teapotlaboratories/atlas/hardware/kicad/atlas.kicad_pcb

## KiCad design hardware/kicad/atlas.kicad_pcb (2024-10-26)

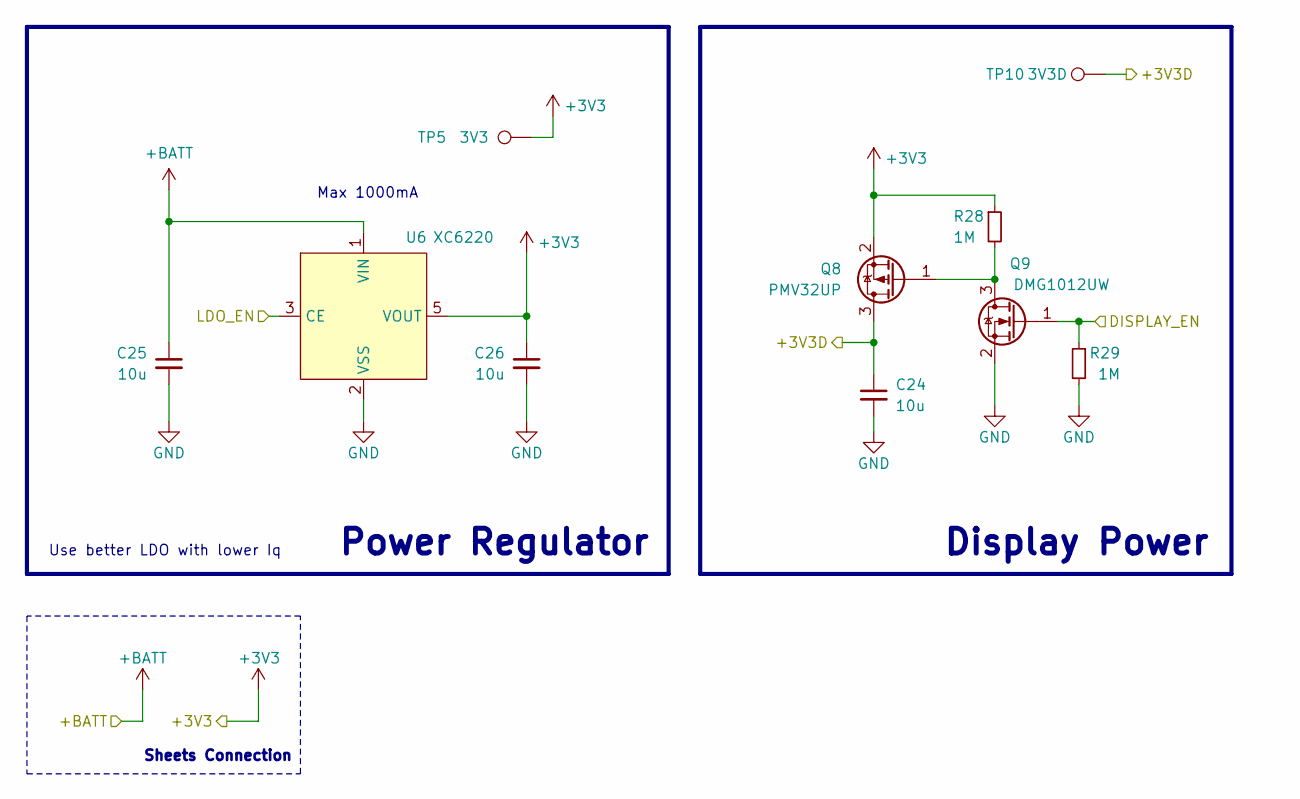
[picture p1: schematic power_regulator.kicad_sch, Teapotlabs Atlas]

Parts:
C24, C25, C26: 10u; C_0603_1608Metric; Part Description Ceramic Capacitor 10V 10uF X5R ±10% 0603
Q8: PMV32UP; SOT-23; Part Description MOSFET P Channel 20V 4A 52mΩ@4.5V
Q9: DMG1012UW; SOT-323_SC-70; Part Description MOSFET N Channel 20V 1A 450mΩ@4.5V 600m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
R28, R29: 1M; R_0402_1005Metric; Part Description Resistor 62.5mW ±1% 1MΩ
TP5: 3V3; TestPoint_Pad_D1.0mm
TP10: 3V3D; TestPoint_Pad_D1.0mm
U6: XC6220; SOT-23-5; Part Description LDO Voltage Regulators 1A

Connections:
/+3V3D: C24.1, Q8.3 (D), TP10.1; also elsewhere on the board
/Main Controller/DISPLAY_EN: Q9.1 (G), R29.1; also elsewhere on the board
/Power Regulator/LDO_EN: U6.3 (CE); also elsewhere on the board
unnamed: Q8.1 (G), Q9.3 (D), R28.2

Notes on the sheet:
Use better LDO with lower Iq
Max 1000mA
Display Power
Sheets Connection
Power Regulator

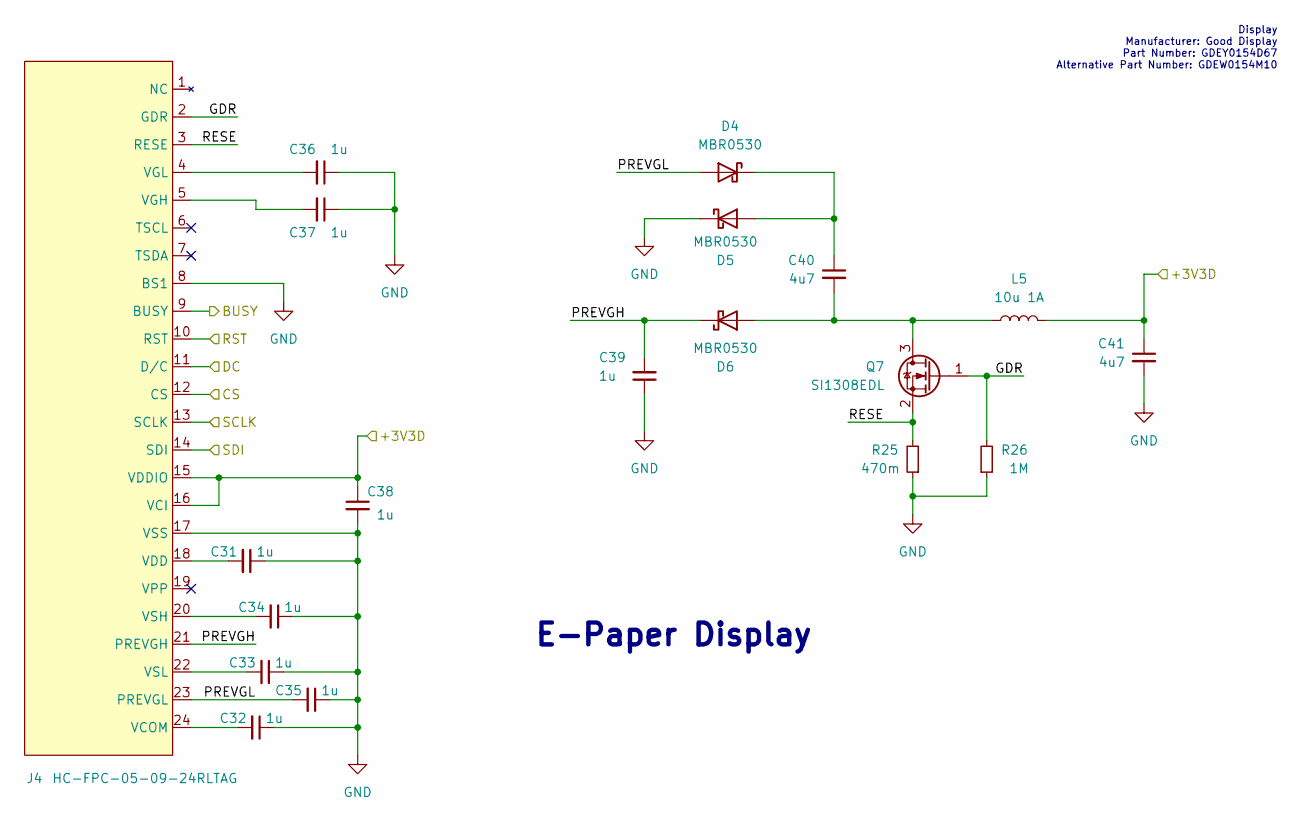
[picture p2: schematic display.kicad_sch, Teapotlabs Atlas]

Parts:
C31, C32, C33, C34, C35, C36, C37, C38, C39: 1u; C_0402_1005Metric; Part Description Ceramic Capacitors 50V 1uF X5R ±10%
C40, C41: 4u7; C_0603_1608Metric; Part Description Ceramic Capacitors 25V 4.7uF X5R ±10%
D4, D5, D6: MBR0530; D_SOD-123; Part Description Schottky Barrier Diodes 30V 430mV@500mA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
J4: HC-FPC-05-09-24RLTAG; FPC-SMD_24P-P0.50_HC-FPC-05-09-24RLTAG; Part Description FFC & FPC Connectors Clamshell 24P Bott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
L5: 10u 1A; L_Changjiang_FNR4012S; Part Description Power Inductors 1A 10uH ±20% 1.1A SMD,4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
Q7: SI1308EDL; SOT-323_SC-70; Part Description MOSFET N Channel 30V 1.4A 132mΩ@10V,1.4A
R25: 470m; R_0402_1005Metric; Part Description Resistor 125mW ±1% 470mΩ
R26: 1M; R_0402_1005Metric; Part Description Resistors 100mW ±1% 1MΩ

Connections:
/+3V3D: C38.1, C41.1, J4.15 (VDDIO), J4.16 (VCI), L5.1; also elsewhere on the board
/Display/BUSY: J4.9 (BUSY); also elsewhere on the board
/Display/CS: J4.12 (CS); also elsewhere on the board
/Display/DC: J4.11 (D/C); also elsewhere on the board
/Display/GDR: J4.2 (GDR), Q7.1 (G), R26.2
/Display/PREVGH: C39.2, D6.1 (K), J4.21 (PREVGH)
/Display/PREVGL: C35.2, D4.2 (A), J4.23 (PREVGL)
/Display/RESE: J4.3 (RESE), Q7.2 (S), R25.2
/Display/RST: J4.10 (RST); also elsewhere on the board
/Display/SCLK: J4.13 (SCLK); also elsewhere on the board
/Display/SDI: J4.14 (SDI); also elsewhere on the board
unnamed: C40.1, D4.1 (K), D5.2 (A)
unnamed: C40.2, D6.2 (A), L5.2, Q7.3 (D)
unnamed: C32.2, J4.24 (VCOM)
unnamed: C31.2, J4.18 (VDD)
unnamed: C37.2, J4.5 (VGH)
unnamed: C36.2, J4.4 (VGL)
unnamed: C34.2, J4.20 (VSH)
unnamed: C33.2, J4.22 (VSL)

Notes on the sheet:
Display Manufacturer: Good Display Part Number: GDEY0154D67 Alternative Part Number: GDEW0154M10
E-Paper Display

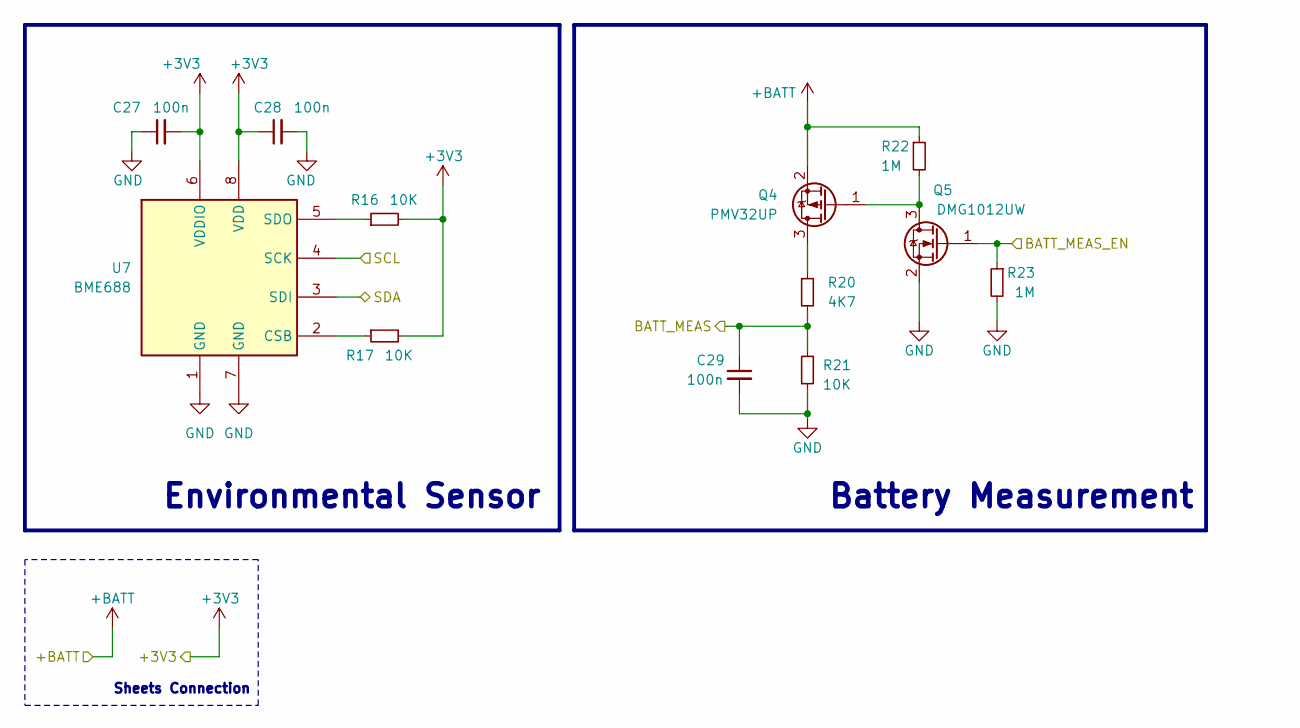
[picture p3: schematic sensor.kicad_sch, Teapotlabs Atlas]

Parts:
C27, C28, C29: 100n; C_0402_1005Metric; Part Description Ceramic Capacitor 16V 100nF X7R ±10%
Q4: PMV32UP; SOT-23; Part Description MOSFET P Channel 20V 4A 52mΩ@4.5V
Q5: DMG1012UW; SOT-323_SC-70; Part Description MOSFET N Channel 20V 1A 450mΩ@4.5V 600m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
R16, R17, R21: 10K; R_0402_1005Metric; Part Description Resistors 62.5mW ±1% 10kΩ
R20: 4K7; R_0402_1005Metric; Part Description Resistor 62.5mW ±1% 4.7kΩ
R22, R23: 1M; R_0402_1005Metric; Part Description Resistor 62.5mW ±1% 1MΩ
U7: BME688; BME680-PSON80P300X300X100-8N; Part Description Gas, Humidity, Pressure, Temperature Se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

Connections:
/Main Controller/BATT_MEAS: C29.1, R20.2, R21.2; also elsewhere on the board
/Main Controller/BATT_MEAS_EN: Q5.1 (G), R23.1; also elsewhere on the board
/SCL: U7.4 (SCK); also elsewhere on the board
/SDA: U7.3 (SDI); also elsewhere on the board
unnamed: Q4.3 (D), R20.1
unnamed: Q4.1 (G), Q5.3 (D), R22.2
unnamed: R17.1, U7.2 (CSB)
unnamed: R16.1, U7.5 (SDO)

Notes on the sheet:
Sheets Connection
Battery Measurement
Environmental Sensor

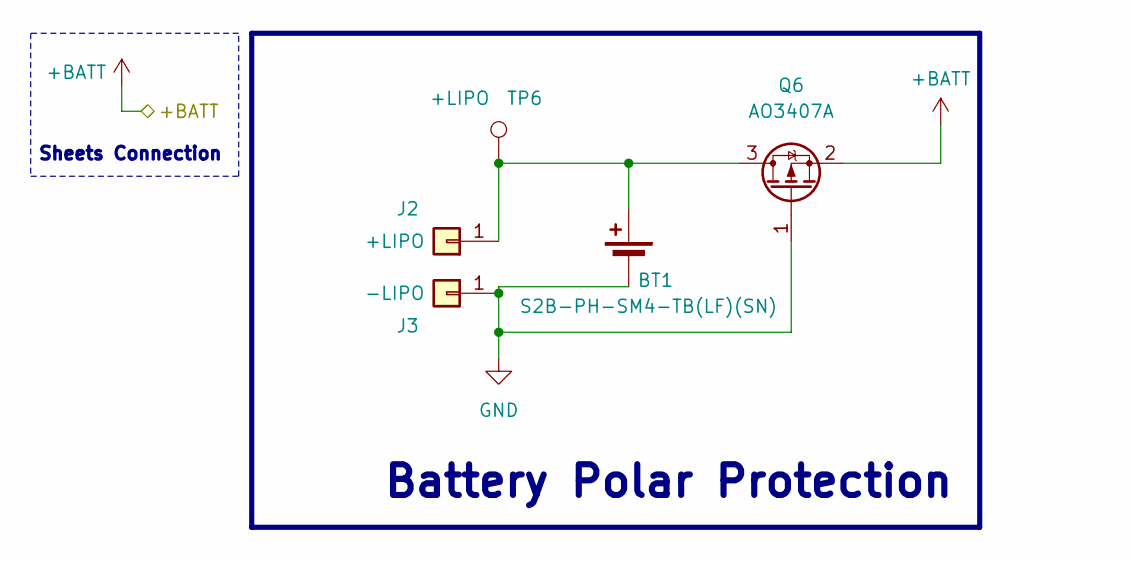
[picture p4: schematic battery.kicad_sch, Teapotlabs Atlas]

Parts:
BT1: S2B-PH-SM4-TB(LF)(SN); JST_PH_S2B-PH-SM4-TB_1x02-1MP_P2.00mm_Horizontal; Part Description Wire To Board Connector 1x2P PH 2mm Mal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
J2: +LIPO; TestPoint_THTPad_D1.0mm_Drill0.5mm; Part Description On-board Pad
J3: -LIPO; TestPoint_THTPad_D1.0mm_Drill0.5mm; Part Description On-board Pad
Q6: AO3407A; SOT-23; Part Description MOSFET P Channel 30V 4.3A 48mΩ@10V,4.3A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
TP6: +LIPO; TestPoint_Pad_D1.0mm

Connections:
unnamed: BT1.1 (+), J2.1, Q6.3 (D), TP6.1

Notes on the sheet:
Battery Polar Protection
Sheets Connection

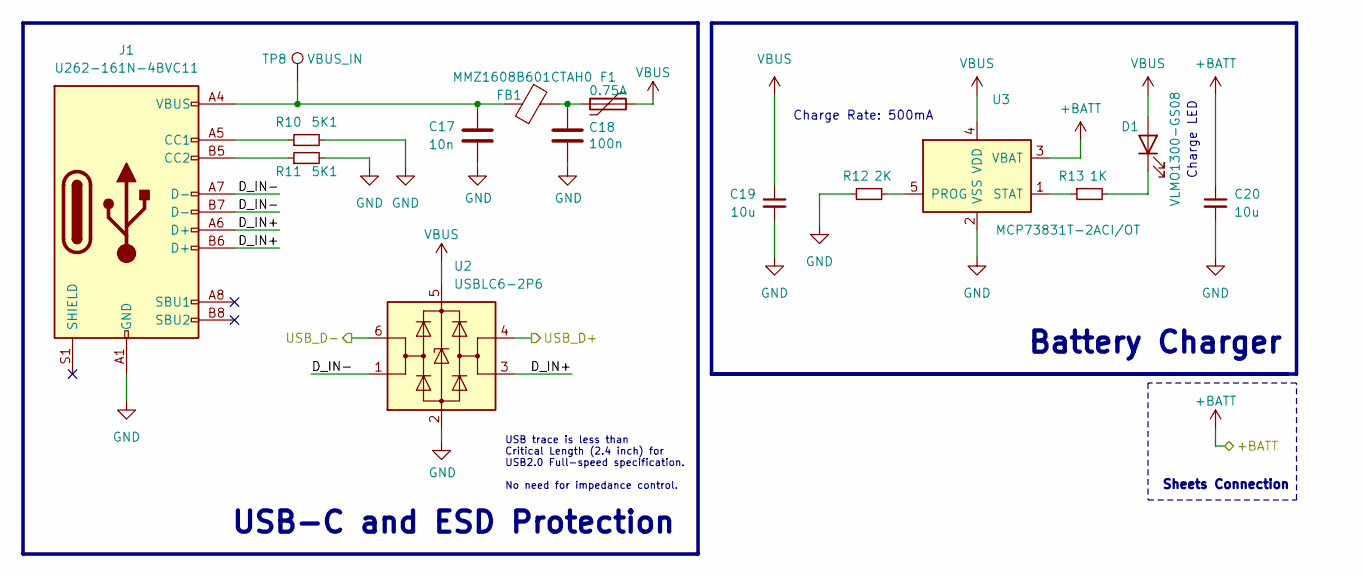
[picture p5: schematic usb_power.kicad_sch, Teapotlabs Atlas]

Parts:
C17: 10n; C_0402_1005Metric; Part Description Ceramic Capacitors 16V 10nF X7R ±10%
C18: 100n; C_0402_1005Metric; Part Description Ceramic Capacitor 16V 100nF X7R ±10%
C19, C20: 10u; C_0603_1608Metric; Part Description Ceramic Capacitor 10V 10uF X5R ±10% 0603
D1: VLMO1300-GS08; LED_0603_1608Metric; Part Description Orange 2V 20mA
F1: 0.75A; Fuse_0805_2012Metric; Part Description Resettable Fuses 6V 750mA 40A 1.5A
FB1: MMZ1608B601CTAH0; L_0603_1608Metric; Part Description Ferrite Beads 400mΩ ±25% 600Ω@100MHz
J1: U262-161N-4BVC11; USB_C_Receptacle_XKB_U262-16XN-4BVC11; Part Description USB Connectors Type-C 3A USB 3.1 16P
R10, R11: 5K1; R_0402_1005Metric; Part Description Resistor 62.5mW ±1% 5.1kΩ
R12: 2K; R_0402_1005Metric; Part Description Resistor 62.5mW ±1% 2kΩ
R13: 1K; R_0402_1005Metric; Part Description Resistor 62.5mW ±1% 1kΩ
TP8: VBUS_IN; TestPoint_Pad_D1.0mm
U2: USBLC6-2P6; SOT-666; Part Description ESD Protection 6V 17V 2 Unidirectional 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
U3: MCP73831T-2ACI/OT; SOT-23-5; Part Description Battery Management IC 6V LiPoly 1500mA

Connections:
/Main Controller/USB_D+: U2.4 (I/O2); also elsewhere on the board
/Main Controller/USB_D-: U2.6 (I/O1); also elsewhere on the board
/USB Power/D_IN+: J1.A6 (D+), J1.B6 (D+), U2.3 (I/O2)
/USB Power/D_IN-: J1.A7 (D-), J1.B7 (D-), U2.1 (I/O1)
unnamed: C17.1, FB1.1, J1.A4 (VBUS), J1.A9 (VBUS), J1.B4 (VBUS), J1.B9 (VBUS), TP8.1
unnamed: C18.1, F1.1, FB1.2
unnamed: D1.1 (K), R13.2
unnamed: J1.A5 (CC1), R10.1
unnamed: J1.B5 (CC2), R11.1
unnamed: R12.1, U3.5 (PROG)
unnamed: R13.1, U3.1 (STAT)
VBUS: C19.1, D1.2 (A), F1.2, U2.5 (VBUS), U3.4 (VDD)

Notes on the sheet:
Sheets Connection
Charge Rate: 500mA
Battery Charger
USB-C and ESD Protection
Charge LED
USB trace is less than Critical Length (2.4 inch) for USB2.0 Full-speed specification. No need for impedance control.

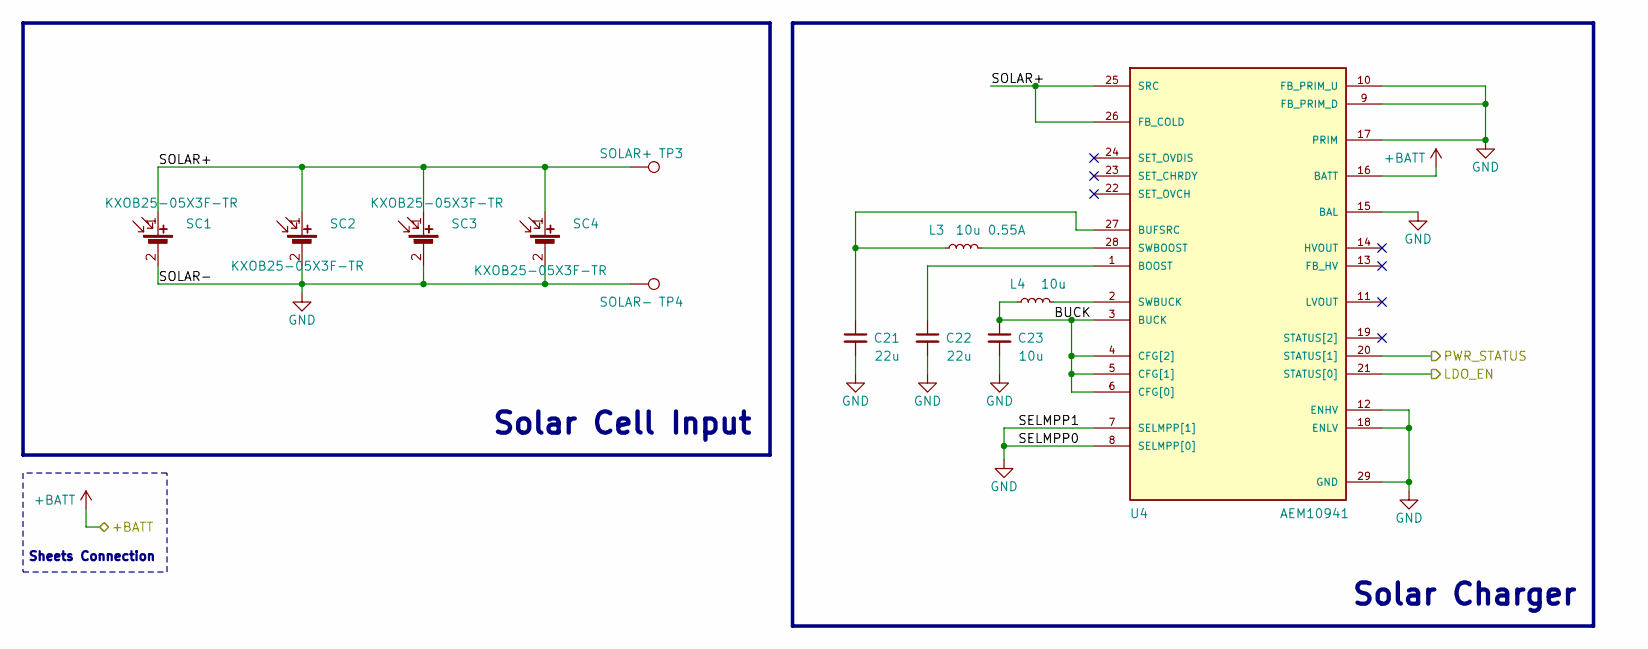
[picture p6: schematic solar_power.kicad_sch, Teapotlabs Atlas]

Parts:
C21, C22: 22u; C_0603_1608Metric; Part Description Ceramic Capacitors 10V 22uF X5R ±20%
C23: 10u; C_0603_1608Metric; Part Description Ceramic Capacitor 10V 10uF X5R ±10%
L3: 10u 0.55A; IND_LPS4012-103MRB; Part Description Power Inductors - SMD 10uH Shld 20% 1.1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
L4: 10u; L_0603_1608Metric; Part Description Power Inductors 10uH ±20% 90mA 1.05Ω
SC1, SC2, SC3, SC4: KXOB25-05X3F-TR; KXOB25-05X3F; Part Description Solar Cell G3 Thin 2.07V 30.7MW
TP3: SOLAR+; TestPoint_Pad_D1.0mm
TP4: SOLAR-; TestPoint_Pad_D1.0mm
U4: AEM10941; QFN-28-1EP_5x5mm_P0.5mm_EP3.35x3.35mm; Part Description PMIC IC - Photovoltaic Energy Harvestin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

Connections:
/Main Controller/PWR_STATUS: U4.20 (STATUS[1]); also elsewhere on the board
/Power Regulator/LDO_EN: U4.21 (STATUS[0]); also elsewhere on the board
/Solar Power/BUCK: C23.1, L4.1, U4.3 (BUCK), U4.4 (CFG[2]), U4.5 (CFG[1]), U4.6 (CFG[0])
/Solar Power/SOLAR+: SC1.1 (+), SC2.1 (+), SC3.1 (+), SC4.1 (+), TP3.1, U4.25 (SRC), U4.26 (FB_COLD)
unnamed: C22.1, U4.1 (BOOST)
unnamed: C21.1, L3.1, U4.27 (BUFSRC)
unnamed: L3.2, U4.28 (SWBOOST)
unnamed: L4.2, U4.2 (SWBUCK)

Notes on the sheet:
Solar Cell Input
Sheets Connection
Solar Charger

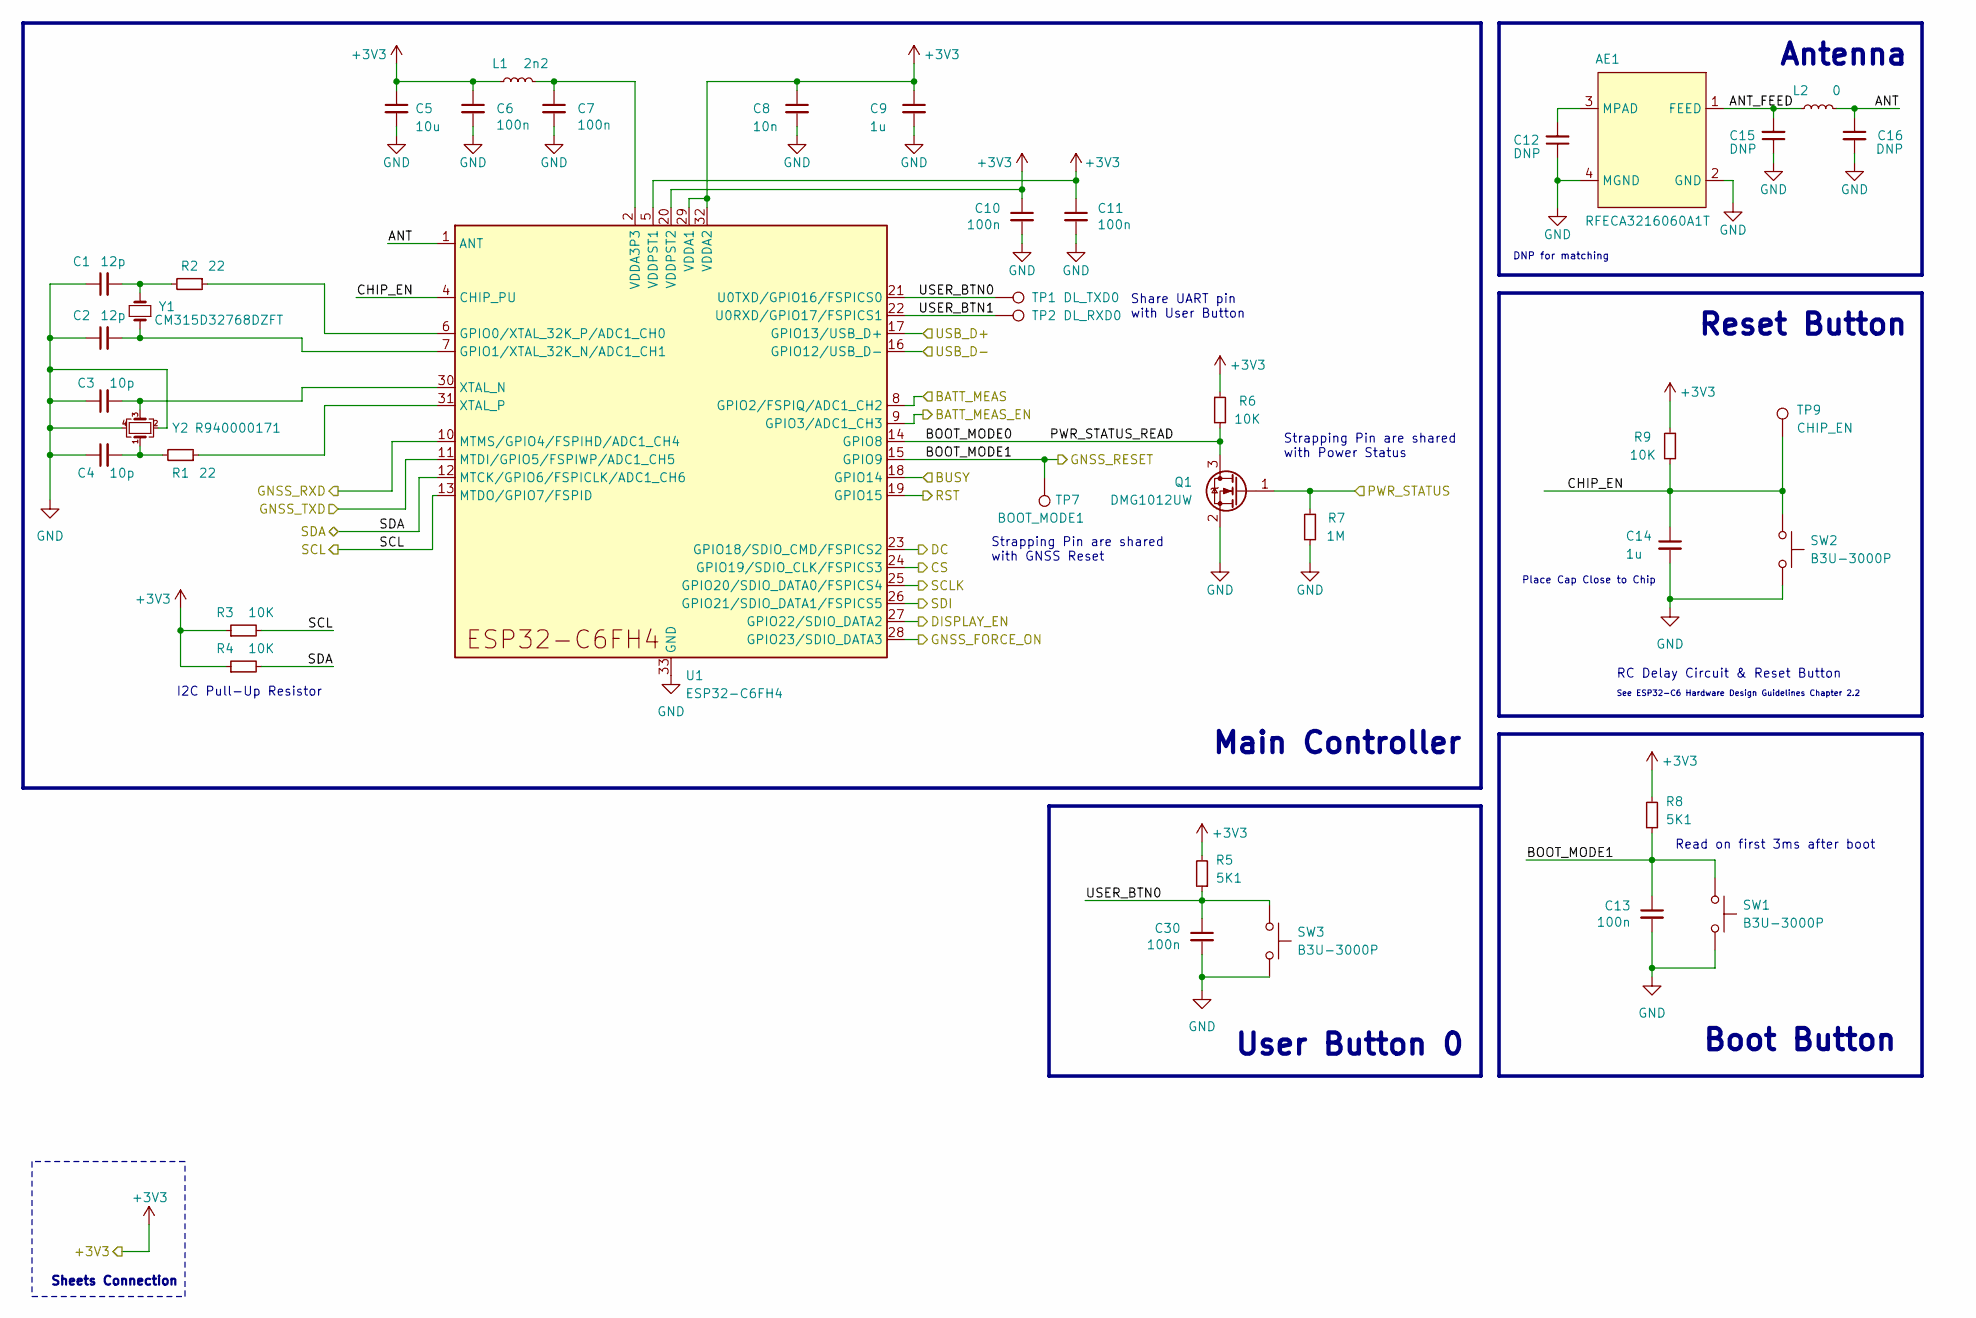
[picture p7: schematic main_controller.kicad_sch, Teapotlabs Atlas]

Parts:
AE1: RFECA3216060A1T; Part Description Chip RF Antenna 2.4GHz 2dBi
C1, C2: 12p; C_0402_1005Metric; Part Description Ceramic Capacitors 50V 12pF C0G ±1%
C3, C4: 10p; C_0402_1005Metric; Part Description Ceramic Capacitors 50V 10pF C0G ±1%
C5: 10u; C_0603_1608Metric; Part Description Ceramic Capacitor 10V 10uF X5R ±10% 0603
C6, C7, C10, C11, C13, C30: 100n; C_0402_1005Metric; Part Description Ceramic Capacitor 16V 100nF X7R ±10%
C8: 10n; C_0402_1005Metric; Part Description Ceramic Capacitors 16V 10nF X7R ±10%
C9, C14: 1u; C_0402_1005Metric; Part Description Ceramic Capacitors 10V 1uF X7R ±10%
C12, C15, C16: DNP; C_0402_1005Metric
L1: 2n2; L_0402_1005Metric; Part Description Power Inductors 2.53A 2.2nH ±2%
L2: 0; L_0402_1005Metric; Part Description Resistor 62.5mW ±1% 0Ω
Q1: DMG1012UW; SOT-323_SC-70; Part Description MOSFET N Channel 20V 1A 450mΩ@4.5V,600m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
R1, R2: 22; R_0402_1005Metric; Part Description Resistor 62.5mW ±1% 22Ω
R3, R4, R6, R9: 10K; R_0402_1005Metric; Part Description Resistors 62.5mW ±1% 10kΩ
R5, R8: 5K1; R_0402_1005Metric; Part Description Resistor 62.5mW ±1% 5.1kΩ
R7: 1M; R_0402_1005Metric; Part Description Resistor 62.5mW ±1% 1MΩ
SW1, SW2, SW3: B3U-3000P; SW_SPST_B3U-3000P; Part Description Tactile Switches NO 50mA 100MΩ 12V 1.59N
TP1: DL_TXD0; TestPoint_Pad_D1.0mm
TP2: DL_RXD0; TestPoint_Pad_D1.0mm
TP7: BOOT_MODE1; TestPoint_Pad_D1.0mm
TP9: CHIP_EN; TestPoint_Pad_D1.0mm
U1: ESP32-C6FH4; QFN-32-1EP_5x5mm_P0.5mm_EP3.6x3.6mm; Part Description Wireless SOC Bluetooth, WiFi Bluetooth 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
Y1: CM315D32768DZFT; Crystal_SMD_3215-2Pin_3.2x1.5mm; Part Description Crystals 32.768kHz 12.5pF ±20ppm
Y2: R940000171; Crystal_SMD_2016-4Pin_2.0x1.6mm; Part Description Crystals 40MHz 9pF ±10ppm

Connections:
/Display/BUSY: U1.18 (GPIO14); also elsewhere on the board
/Display/CS: U1.24 (GPIO19/SDIO_CLK/FSPICS3); also elsewhere on the board
/Display/DC: U1.23 (GPIO18/SDIO_CMD/FSPICS2); also elsewhere on the board
/Display/RST: U1.19 (GPIO15); also elsewhere on the board
/Display/SCLK: U1.25 (GPIO20/SDIO_DATA0/FSPICS4); also elsewhere on the board
/Display/SDI: U1.26 (GPIO21/SDIO_DATA1/FSPICS5); also elsewhere on the board
/GNSS/GNSS_RXD: U1.10 (MTMS/GPIO4/FSPIHD/ADC1_CH4); also elsewhere on the board
/GNSS/GNSS_TXD: U1.11 (MTDI/GPIO5/FSPIWP/ADC1_CH5); also elsewhere on the board
/Main Controller/ANT: C16.1, L2.2, U1.1 (ANT)
/Main Controller/ANT_FEED: AE1.1 (FEED), C15.2, L2.1
/Main Controller/BATT_MEAS: U1.8 (GPIO2/FSPIQ/ADC1_CH2); also elsewhere on the board
/Main Controller/BATT_MEAS_EN: U1.9 (GPIO3/ADC1_CH3); also elsewhere on the board
/Main Controller/BOOT_MODE0: Q1.3 (D), R6.2, U1.14 (GPIO8)
/Main Controller/BOOT_MODE1: C13.1, R8.1, SW1.1, TP7.1, U1.15 (GPIO9); also elsewhere on the board
/Main Controller/CHIP_EN: C14.1, R9.2, SW2.1, TP9.1, U1.4 (CHIP_PU)
/Main Controller/DISPLAY_EN: U1.27 (GPIO22/SDIO_DATA2); also elsewhere on the board
/Main Controller/PWR_STATUS: Q1.1 (G), R7.1; also elsewhere on the board
/Main Controller/USB_D+: U1.17 (GPIO13/USB_D+); also elsewhere on the board
/Main Controller/USB_D-: U1.16 (GPIO12/USB_D-); also elsewhere on the board
/Main Controller/USER_BTN0: C30.1, R5.1, SW3.1, TP1.1, U1.21 (U0TXD/GPIO16/FSPICS0)
/Main Controller/USER_BTN1: TP2.1, U1.22 (U0RXD/GPIO17/FSPICS1)
/SCL: R3.2, U1.13 (MTDO/GPIO7/FSPID); also elsewhere on the board
/SDA: R4.2, U1.12 (MTCK/GPIO6/FSPICLK/ADC1_CH6); also elsewhere on the board
unnamed: AE1.3 (MPAD), C12.2
unnamed: C7.1, L1.2, U1.2 (VDDA3P3), U1.3 (VDDA3P3)
unnamed: R2.1, U1.6 (GPIO0/XTAL_32K_P/ADC1_CH0)

Notes on the sheet:
Place Cap Close to Chip
Reset Button
Antenna
DNP for matching
Main Controller
Sheets Connection
User Button 0
Share UART pin with User Button
Boot Button
See ESP32-C6 Hardware Design Guidelines Chapter 2.2
RC Delay Circuit & Reset Button
Read on first 3ms after boot
I2C Pull-Up Resistor
Strapping Pin are shared with Power Status
Strapping Pin are shared with GNSS Reset

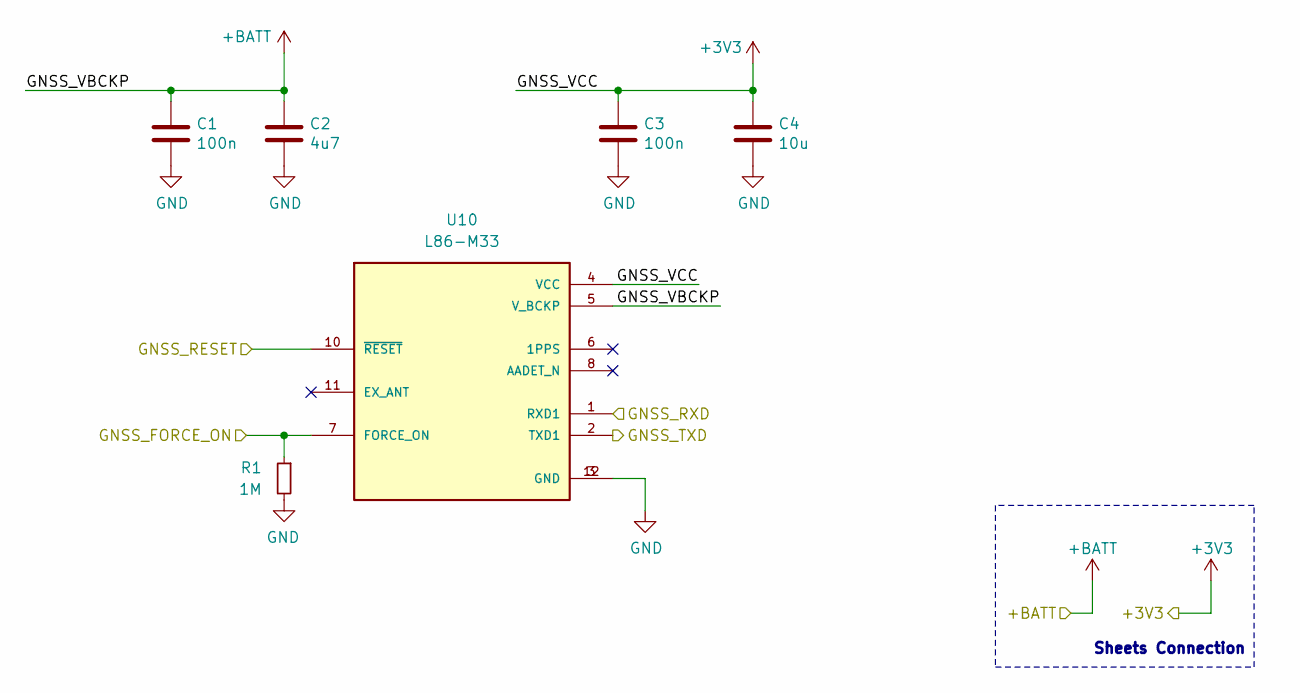
[picture p8: schematic gnss.kicad_sch, Teapotlabs Atlas]

Parts:
C1, C3: 100n; C_0603_1608Metric
C2: 4u7; C_0603_1608Metric
C4: 10u; C_0603_1608Metric
R1: 1M; R_0402_1005Metric
U10: L86-M33

Connections:
/GNSS/GNSS_RXD: U10.1 (RXD1); also elsewhere on the board
/GNSS/GNSS_TXD: U10.2 (TXD1); also elsewhere on the board
/Main Controller/BOOT_MODE1: U10.10 (~RESET); also elsewhere on the board

Notes on the sheet:
Sheets Connection

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
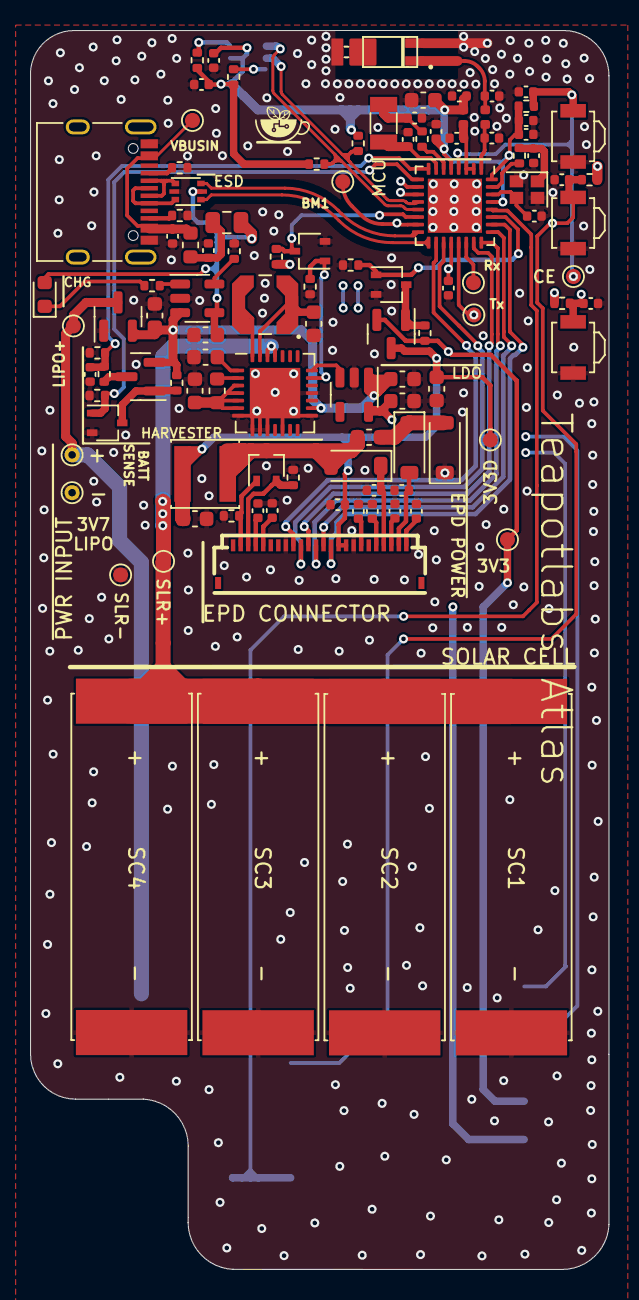
[picture p9: board atlas.kicad_pcb from above]

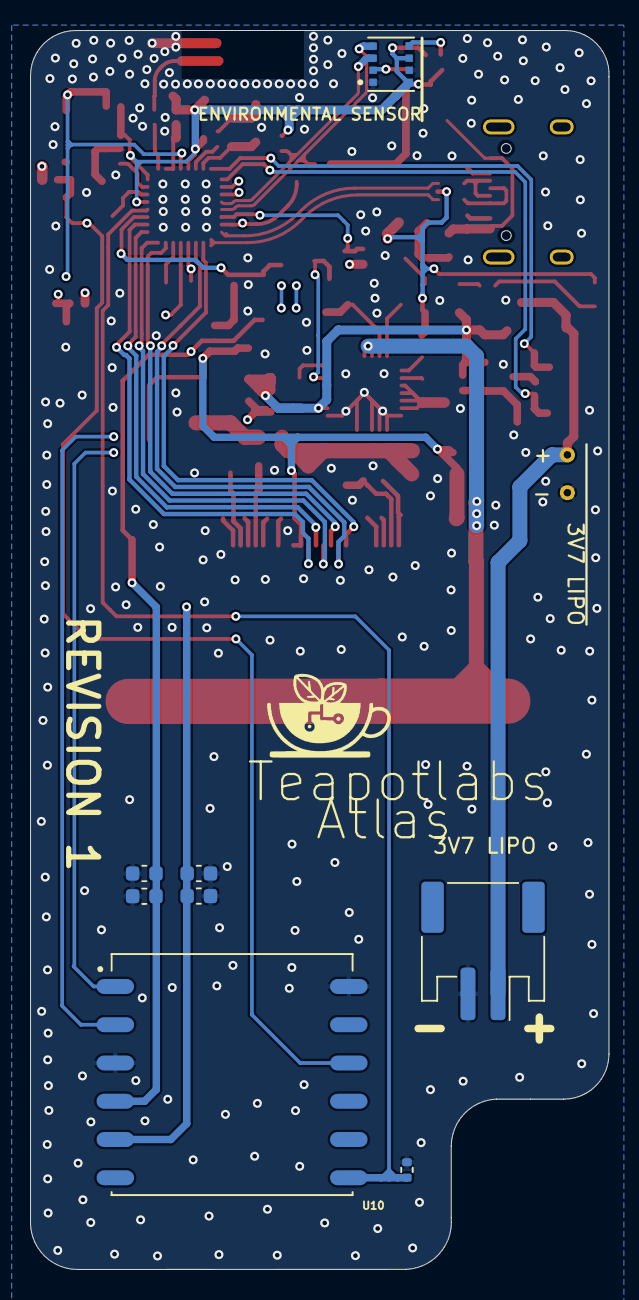
[picture p10: board atlas.kicad_pcb from below]

Board: 4 copper layers, 38.4 x 82.2 mm, 119 parts (8 on the bottom side), 71 nets.

Other parts of the board:
C42, C44: 100n; C_0603_1608Metric
C43: 4u7; C_0603_1608Metric
C45: 10u; C_0603_1608Metric
R15: 1M; R_0402_1005Metric
