teapotlaboratories/atlas/(commit log)

2024-10-19 initial upload
    [atlas.kicad_pcb, atlas.kicad_sch, battery.kicad_sch, display.kicad_sch, gnss.kicad_sch, main_controller.kicad_sch, power_regulator.kicad_sch, sensor.kicad_sch]
2024-10-20 update schematics with gnss
    [atlas.kicad_sch, gnss.kicad_sch, main_controller.kicad_sch, solar_power.kicad_sch]
2024-10-20 update pcb
    [atlas.kicad_pcb, gnss.kicad_sch, main_controller.kicad_sch]
2024-10-20 update design
    [atlas.kicad_pcb]
2024-10-21 Added a button for menu control (only pcb and no routing)
    [atlas.kicad_pcb]
2024-10-22 add second user button
    [atlas.kicad_pcb, main_controller.kicad_sch]
2024-10-22 added led symbols and placements on pcb.
    [atlas.kicad_pcb]
2024-10-25 Revert "added led symbols and placements on pcb."
    This reverts commit 775bc6ae91366f689438663b29cde4e2220ca0a7.
    [atlas.kicad_pcb]
2024-10-26 add gerber
2024-10-26 update schematics info
    [atlas.kicad_pcb, atlas.kicad_sch, battery.kicad_sch, display.kicad_sch, gnss.kicad_sch, main_controller.kicad_sch, power_regulator.kicad_sch, sensor.kicad_sch]
